fangxx3863/SDVX-CON/README.md

# SDVX-CON
**基于STC8H8K64U的SDVX键盘轴小手台**  
**成本不到60RMB!!!**  


# 注意  
工程使用VSCode的EIDE插件配合Keil5-C51框架进行开发,构建源码前请先下载VSCode,Keil5,VSCode安装EIDE插件  
如若不想修改源代码,请下载Release内的预编译文件  

# DIY制作指南  
**本项目大部分元件使用0603封装贴片件,有一定的焊接难度,请准备好适合的工具**  

## 准备工具及材料  
### 工具  
1. 一把合适的烙铁,推荐T12(不要弄那些几十块的那种来焊,你会自闭的)  
2. 加热台,买淘宝那种十几块的LED拆焊台即可(非必须)  
3. 万用表
4. 镊子

### 材料  
1. 有铅中温锡膏(用以焊接贴片元件,非必须)
2. 焊锡丝
3. 助焊剂/焊宝/松香(辅助焊接)
4. 打样主板PCB
5. 打样定位板PCB(推荐铝基板,手感更佳)
6. [此目录下的元件](https://github.com/fangxx3863/SDVX-CON/tree/main/extra)

## 开始制作  
### 主板焊接(加热台法,推荐)  
1. 将所有焊点涂上焊膏,注意量不要太多  
2. 使用立创专业版的辅助焊接工具对照3D预览将元件全部用镊子小心放置于焊盘上  
3. 将PCB移至加热台加热,待焊锡融化后用镊子将未归位的元件推齐  
4. 完成后将电路板放于地板加速冷却  
5. 接着打开烙铁,用刀头处理MCU引脚,防止连锡  
6. 确认焊接无误最后焊接EC12旋钮,注意要与PCB平面水平对齐  
7. 主控板焊接完成  

### 主板焊接(烙铁法)  
1. 在全部阻容,LED,二极管位置用烙铁上一边焊盘的锡
2. 使用立创专业版的辅助焊接工具对照3D预览将元件用镊子小心放置于焊盘上  
3. 烙铁加热有锡一边焊盘直到元件紧贴PCB平面  
4. 在另一侧焊盘用烙铁上锡  
5. 直至全部阻容,LED,二极管焊接完成(注意二极管方向)  
6. 于MCU焊盘上涂大量焊油  
7. 放上MCU,加焊锡用刀头拖好(注意元件方向)  
8. 焊接凯华轴座  
6. 确认其他焊接无误最后焊接EC12旋钮,注意要与PCB平面水平对齐  
7. 主控板焊接完成  

### 组装  
1. 将M3螺丝放于定位板打孔位置上  
2. 背面使用螺母固定,并于螺母后套上弹簧垫圈  
3. 将定位板扣于主板之上,并在主板背面使用螺母固定  
4. 插入键盘轴,调整主板背面螺母松紧直至全部键盘轴卡入到位  
5. 套上旋钮帽,轴帽

### 程序  
#### 上传程序  
1. 进入[发布页](https://github.com/fangxx3863/SDVX-CON/releases)下载最新预构建文件  
2. 下载[STC-ISP](https://github.com/fangxx3863/SDVX-CON/blob/main/extra/stc-isp-v6.90K.exe)下载工具  
3. 打开STC-ISP并按下图设置  
    
4. 确认无误后点击下载/编程  
5. 按住主板背后的USB-ISP按钮的同时插入USB线,如无意外则程序自动开始下载  
6. 如果未开始下载,可再按下RST按钮  
7. 等待下载完成即可使用  
8. 供参考的SpiceTools设置  
  

#### 二次开发  
1. 克隆本项目并用VSCode打开  
2. 点开EIDE图标展开EIDE项目,构建选项  
3. 点击构建器选项旁边的笔图标  
4. 进入全局选项选项卡将RAM/ROM模式均改为LARGE,并点击右上角全部保存按钮  
5. 程序修改完毕后按右上角下载图标即可完成编译  

### 后记  
做这个台子还算顺利的,这也是我第一次玩STC的单片机,也算是学习了,代码写的挺烂的,但是胜在能用(笑)  
祝各位早日FC!!!  
