fangxx3863/SDVX-CON/extra/README.md

# 注意事项

PCB文件已经过验证可用,导入立创EDA专业版打样即可  
附件中也提供了对应的制版文件,可到其他平台打样  

# 修订  
PCB中C2/C3的22uF电容不装  

# 元件购买

物料清单如下(所有物品均可在淘宝找到)： 

名称                          |      价格(RMB)
------------------------------|--------------
M3不锈钢开口弹簧垫圈 200个|1.96
M3不锈钢螺丝 50个|1.42
M3不锈钢螺母 80个|2.47
外铝内塑旋钮帽30x17(外径x高度)6mm半轴 2个|3.90
ABS键帽 1套|9.90
ZMM3V6稳压贴片二极管 50个|1.50
0603贴片电容100nF 200个|2.00
0603贴片电容10uF 50个|2.00
0603贴片电阻10K 50个|0.80
0603贴片电阻300R 50个|0.80
0603贴片电阻22R 200个|1.50
EC12旋转编码器 2个|1.98
凯华热插拔轴座 10个|8.70
WS2812B-3528反贴LED 10个|6.40
3\*6\*2.5贴片开关20颗|1.80
TYPEC16P全贴片插座有柱 1个|0.58
STC8H8K64U-TSSOP20 1个|2.92
高特红轴 10颗|5.00
总价|55.63
